ggurov/hellen88bmw/boards/hellen88bmw-d/board/hellen88bmw-d.png

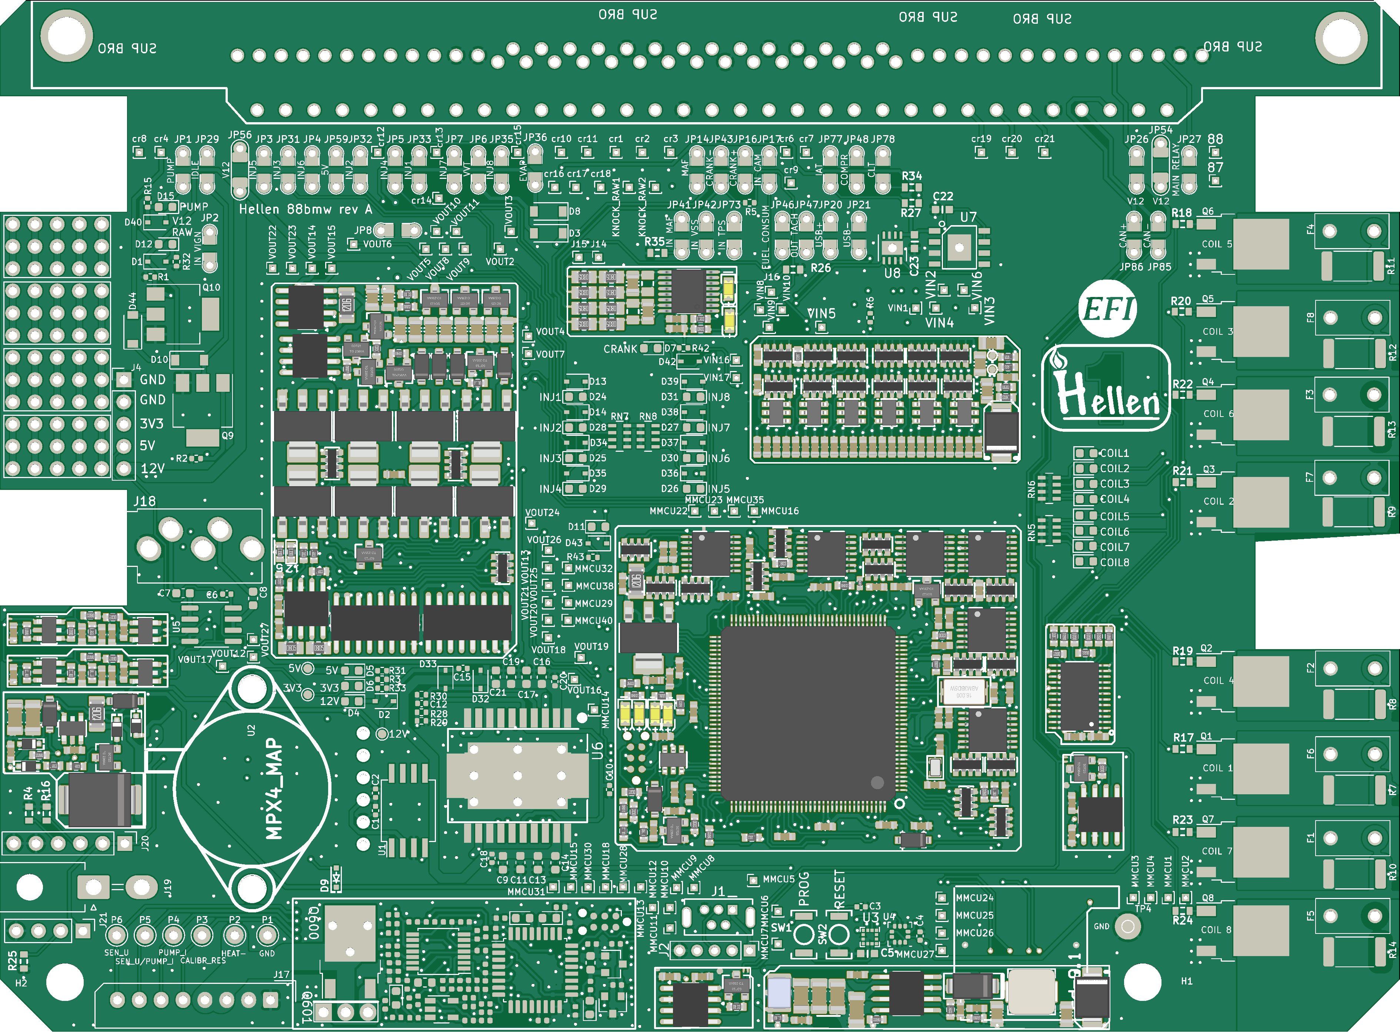
boards/hellen88bmw-d/board/hellen88bmw-d.png
