ggurov/hellen88bmw/boards/hellen88bmw-d/board/misc/hellen88bmw-d-bottom.png

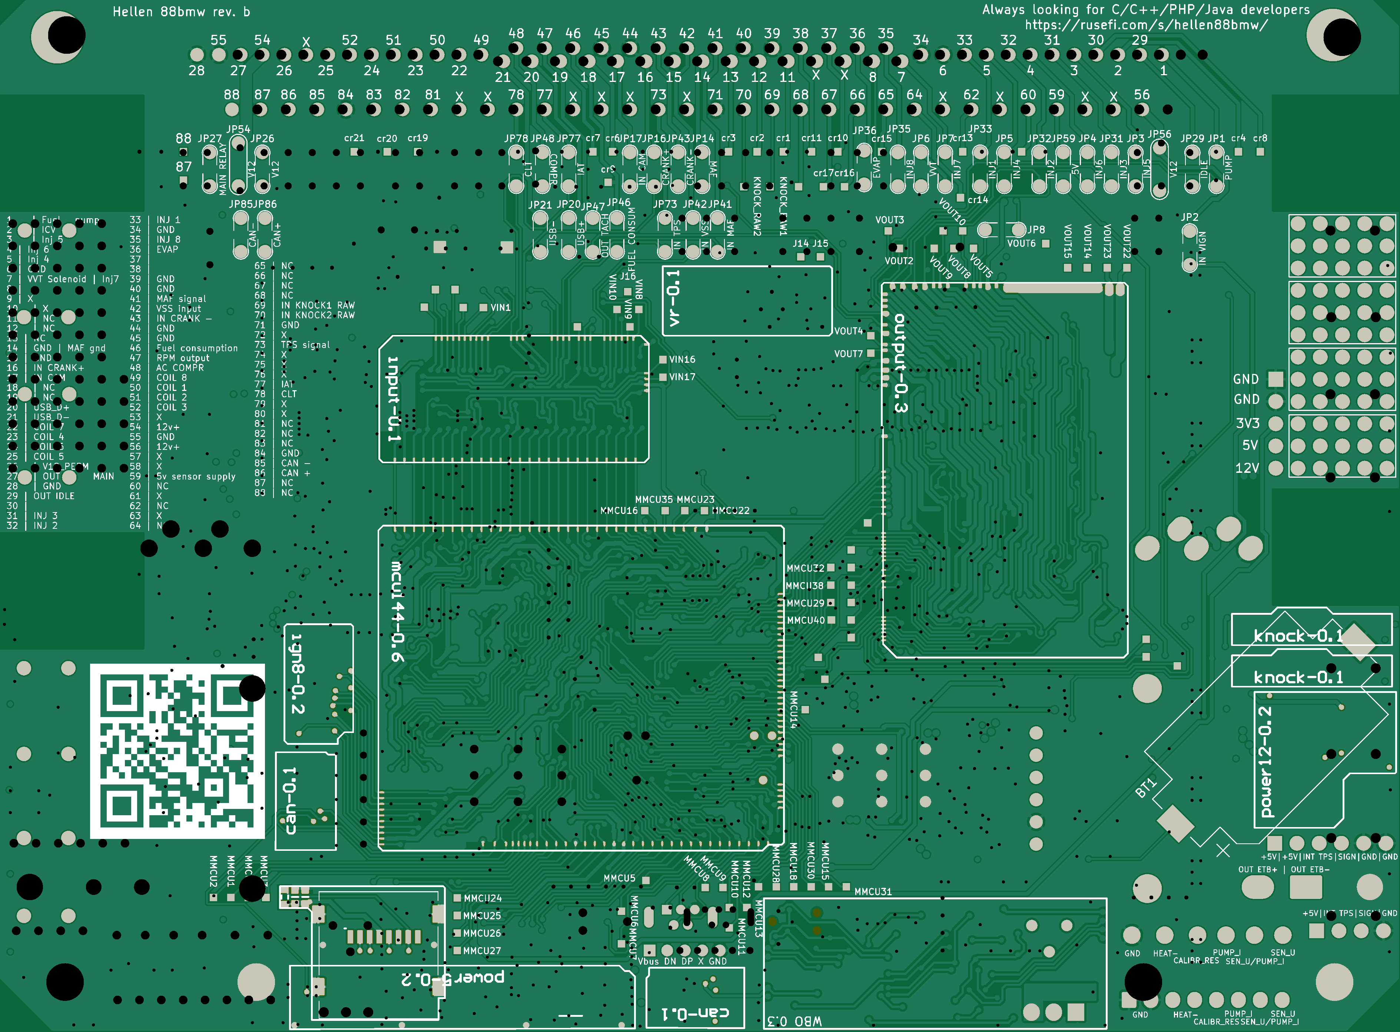
boards/hellen88bmw-d/board/misc/hellen88bmw-d-bottom.png
