ggurov/hellen88bmw/boards/hellen88bmw-d/board/misc/hellen88bmw-d-top.png

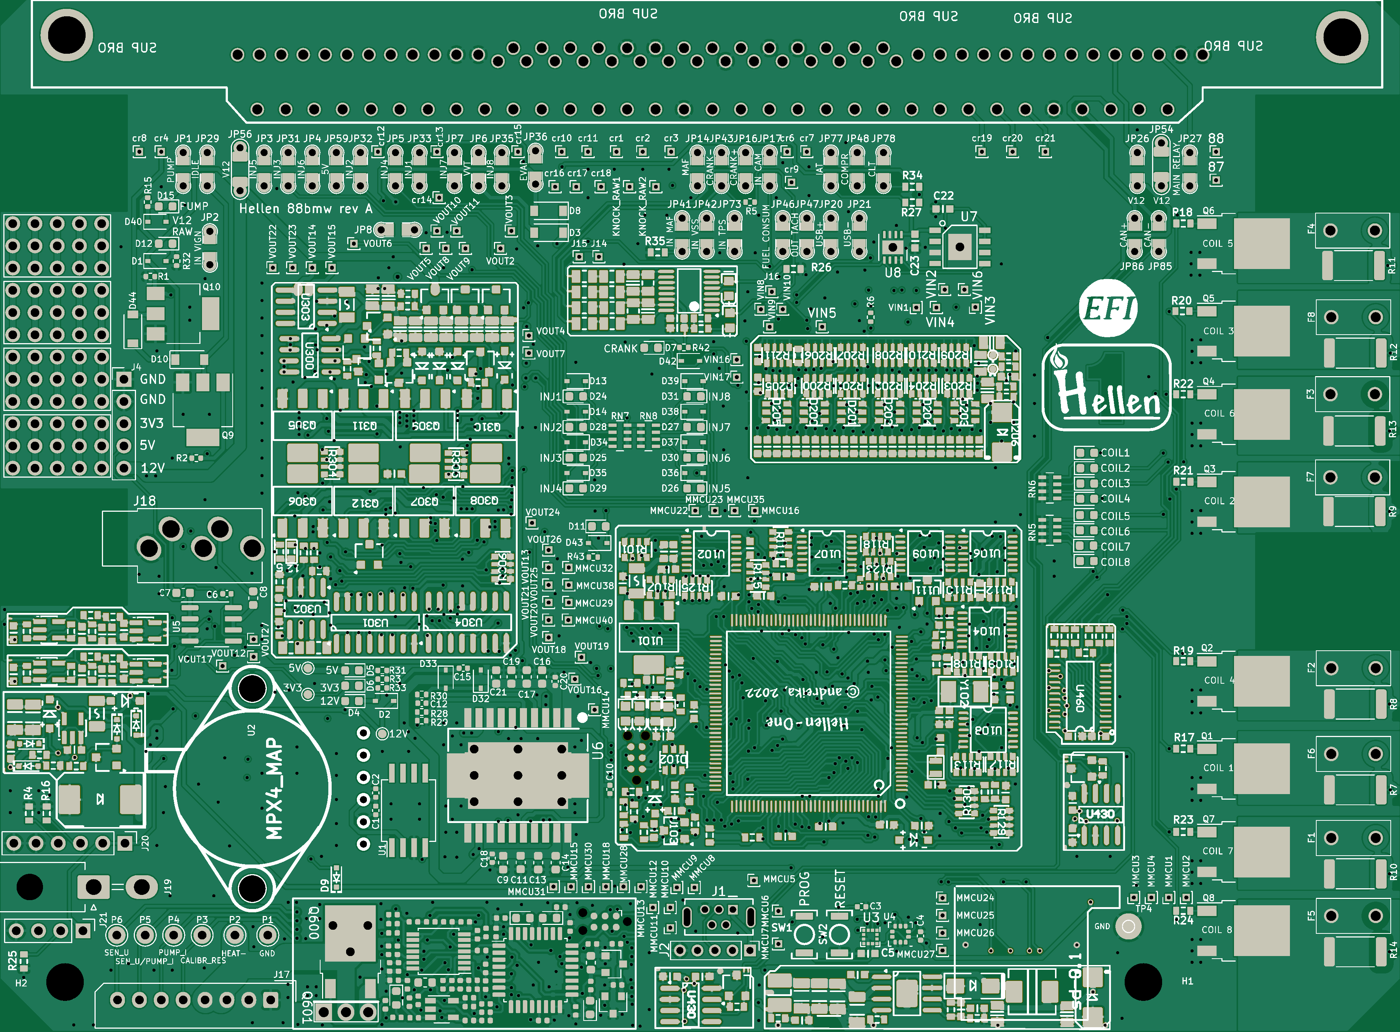
boards/hellen88bmw-d/board/misc/hellen88bmw-d-top.png
