ggurov/hellen88bmw/boards/hellen88bmw-d/frame/88bmw-BOM.csv

Comment | Designator | Footprint | LCSC Part #
BATTERY_CR2032 | BT1 | BATTERY-2032 | C70377
100nF | C1 | C0402 | C307331
100nF | C2 | C0402 | C307331
100nF | C3 | C0402 | C307331
100nF | C4 | C0402 | C307331
100n | C5 | C0603 | C14663
100nF | C6 | C0402 | C307331
10u | C7 | C0603 | C96446
10u | C8 | C0603 | C96446
10u | C9 | C0603 | C96446
5.6nF | C10 | C0402 | C115688
10u | C11 | C0603 | C96446
10nF | C12 | C0402 | C15195
10u | C13 | C0603 | C96446
10u | C14 | C0603 | C96446
220nF | C15 | C0402 | C16772
10u | C16 | C0603 | C96446
10u | C17 | C0603 | C96446
100nF | C18 | C0402 | C307331
10u | C19 | C0603 | C96446
100nF | C20 | C0402 | C307331
10u | C21 | C0603 | C96446
1u | C22 | C0603 | C15849
1u | C23 | C0603 | C15849
cr | cr1 | PinHeader_1x01_P1.00mm_Vertical
cr | cr2 | PinHeader_1x01_P1.00mm_Vertical
cr | cr3 | PinHeader_1x01_P1.00mm_Vertical
cr | cr4 | PinHeader_1x01_P1.00mm_Vertical
cr | cr6 | PinHeader_1x01_P1.00mm_Vertical
cr | cr7 | PinHeader_1x01_P1.00mm_Vertical
cr | cr8 | PinHeader_1x01_P1.00mm_Vertical
cr | cr9 | PinHeader_1x01_P1.00mm_Vertical
cr | cr10 | PinHeader_1x01_P1.00mm_Vertical
cr | cr11 | PinHeader_1x01_P1.00mm_Vertical
cr | cr12 | PinHeader_1x01_P1.00mm_Vertical
cr | cr13 | PinHeader_1x01_P1.00mm_Vertical
cr | cr14 | PinHeader_1x01_P1.00mm_Vertical
cr | cr15 | PinHeader_1x01_P1.00mm_Vertical
cr | cr16 | PinHeader_1x01_P1.00mm_Vertical
cr | cr17 | PinHeader_1x01_P1.00mm_Vertical
cr | cr18 | PinHeader_1x01_P1.00mm_Vertical
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
VOUT4 | VOUT22 | PinHeader_1x01_P1.00mm_Vertical
VOUT4 | VOUT23 | PinHeader_1x01_P1.00mm_Vertical
VOUT4 | VOUT24 | PinHeader_1x01_P1.00mm_Vertical
VOUT4 | VOUT25 | PinHeader_1x01_P1.00mm_Vertical
VOUT4 | VOUT26 | PinHeader_1x01_P1.00mm_Vertical
VOUT4 | VOUT27 | PinHeader_1x01_P1.00mm_Vertical
