ggurov/hellen88bmw/boards/hellen88bmw-d/frame/88bmw-schematic.pdf

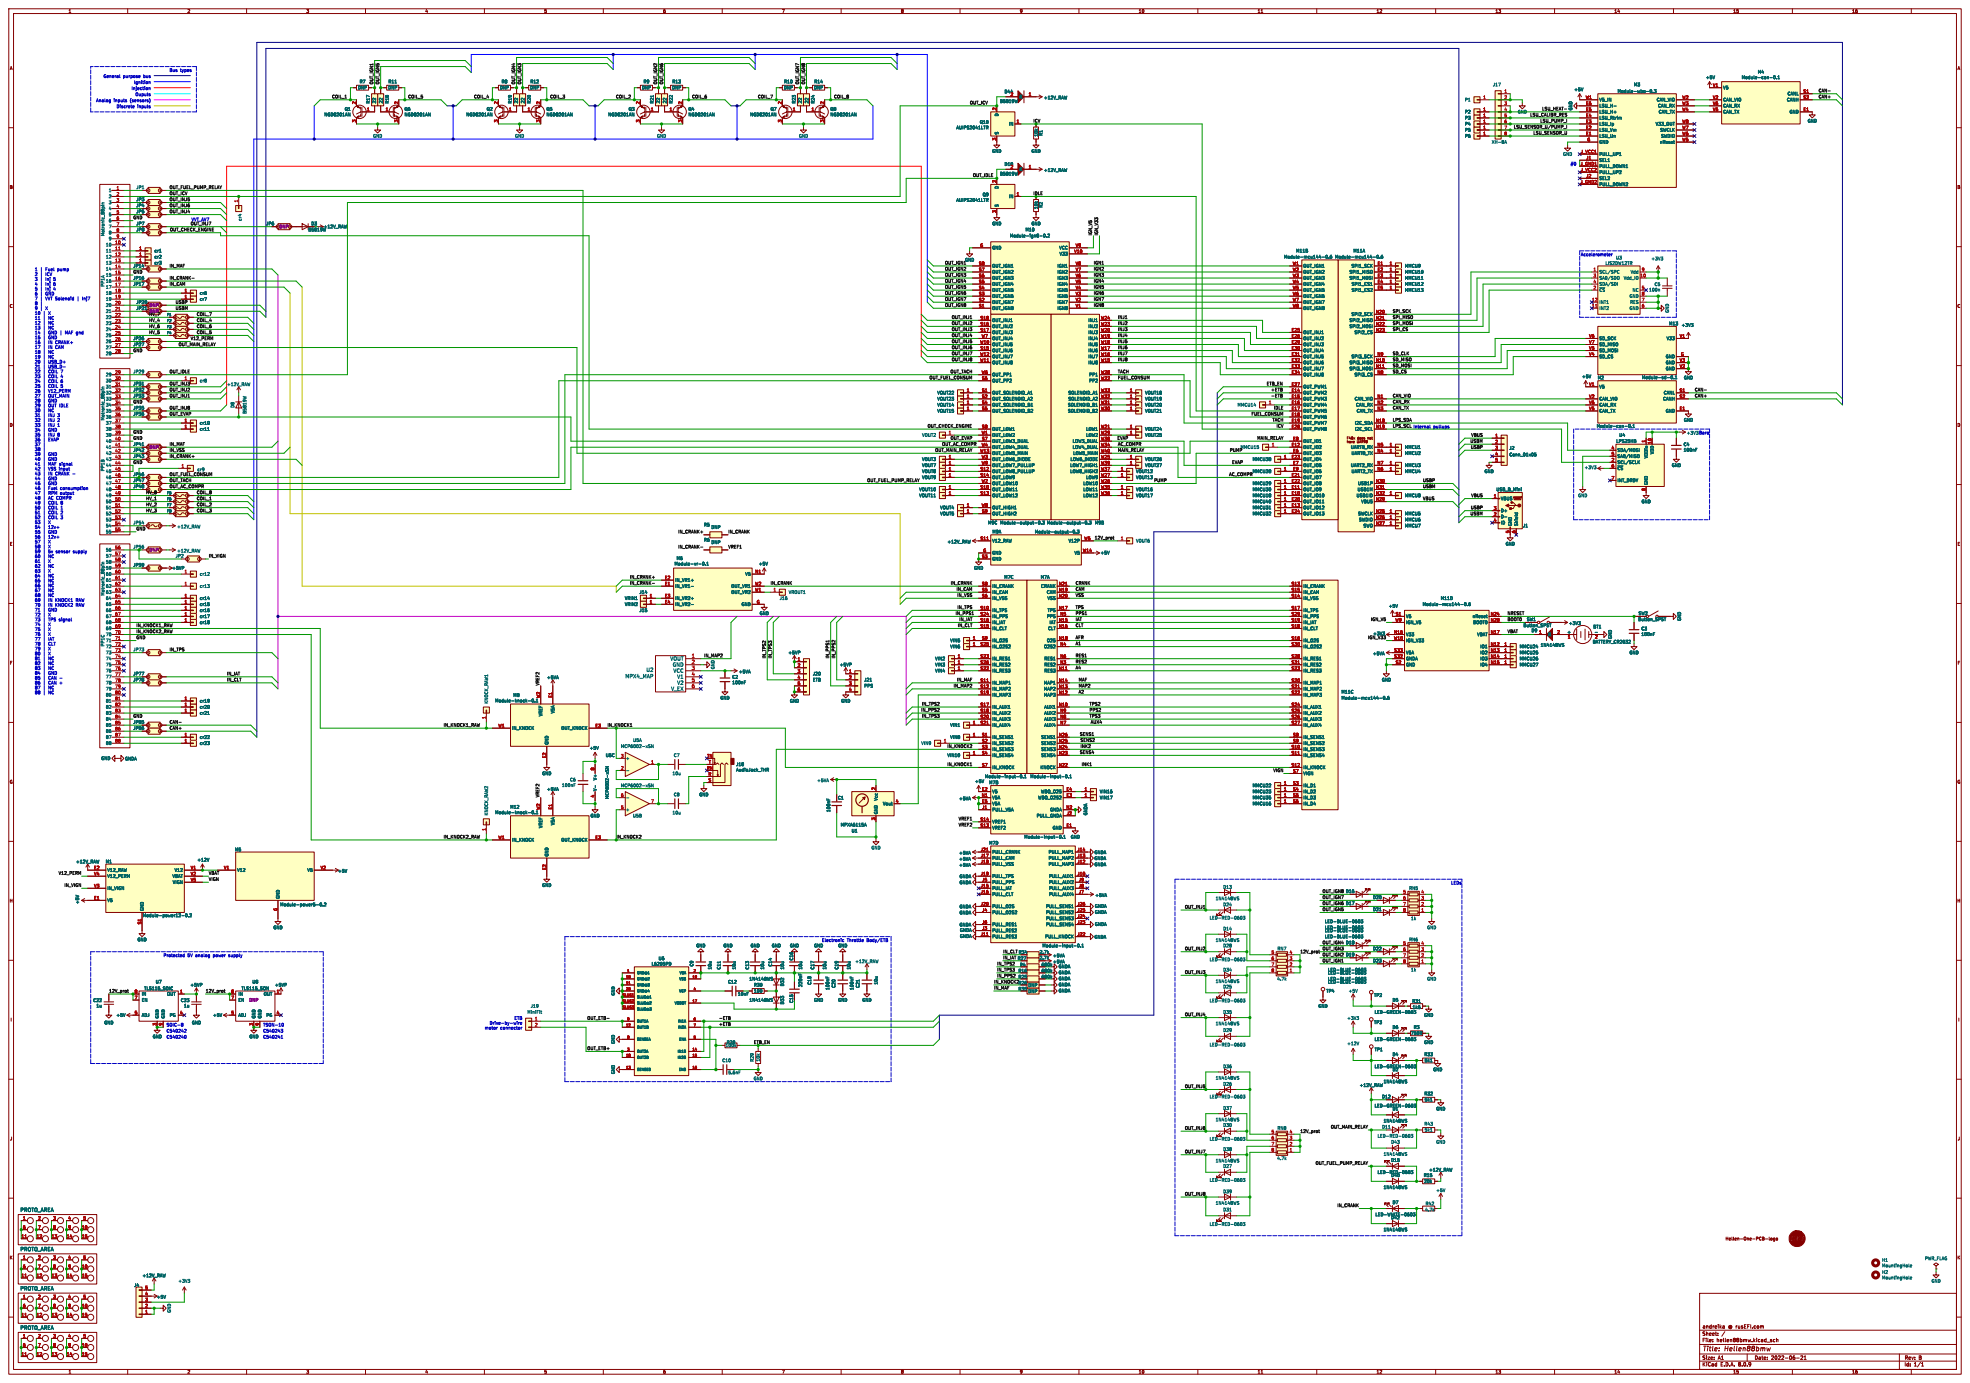
[picture p4: page 1]

40 | GND
41 | MAF signal 42 | VSS input 43 | IN CRANK - 44 | GND

45 | GND
46 | Fuel consumption
47 | RPM output 48 | AC COMPR

8 +5V M8 Module-knock-0.1 V5A E1 GND E2 OUT_KNOCK E3 IN_KNOCK W1 VREF W2 +5V M6 Module-vr-0.1

IAT N15 CLT N16 TPS N17 O2S N18 CAM

IAT CAM

1 KNOCK_RAW2 +5V V5A E1 GND E2 OUT_KNOCK E3 IN_KNOCK W1 VREF M8 W2 Module-knock-0.1

J26 PULL_RES2
GNDA GNDA

File: hellen88bmw.kicad_sch Sheet: / andreika @ rusEFI.com
