ggurov/hellen88bmw/(commit log)

2025-03-06 [skip actions] Auto-generated board
    [hellen88bmw-B_Cu.gbl, hellen88bmw-B_Mask.gbs, hellen88bmw-B_Paste.gbp, hellen88bmw-B_Silkscreen.gbo, hellen88bmw-Edge_Cuts.gm1, hellen88bmw-F_Cu.gtl, hellen88bmw-F_Mask.gts, hellen88bmw-F_Paste.gtp]
2025-03-06 add -d
    [bom_replace_hellen88bmw-d.csv]
